Exocet-Polytechnique/exo-template-pcb/template.kicad_pcb

## KiCad design template.kicad_pcb (2026-11-06)

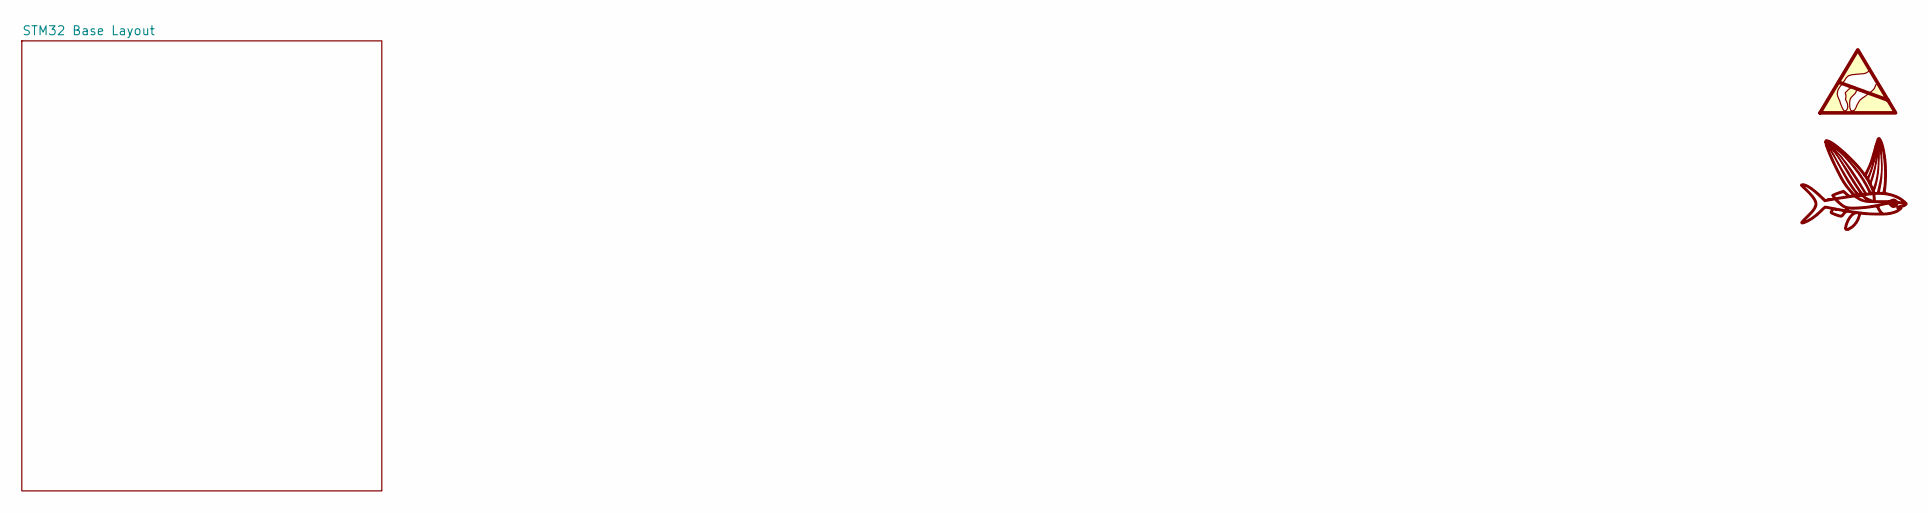
[picture p1: schematic template.kicad_sch, Main page]

Parts:
SYM1: SYM_ESD_Large; ESD-Logo_8.9x8mm_SilkScreen
SYM2: SYM_Logo_Exocet

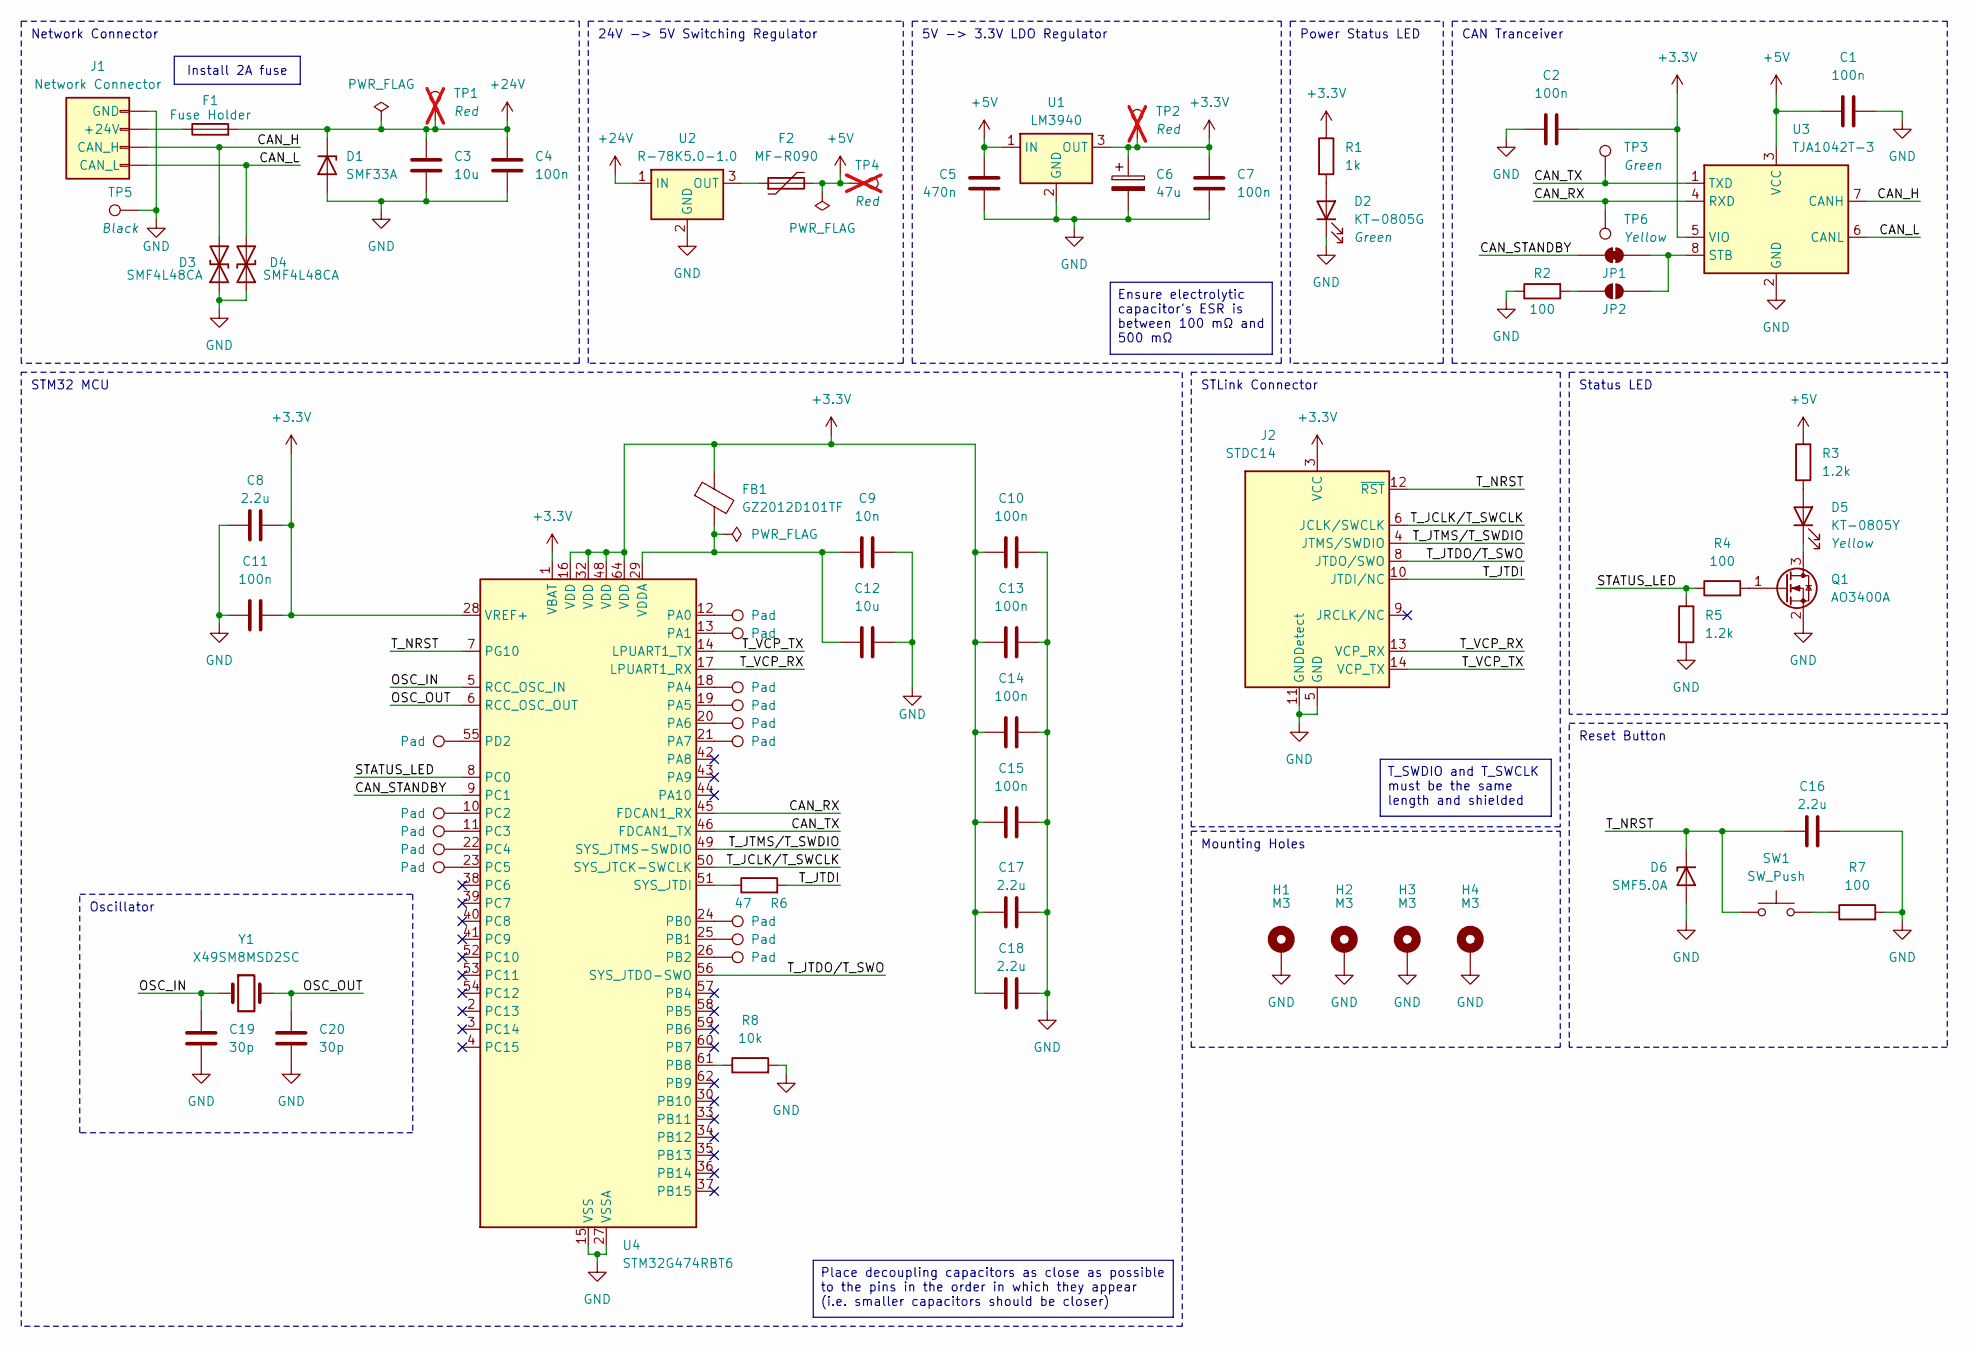
[picture p2: schematic stm32_base.kicad_sch, STM32 Base Layout]

Parts:
C1, C2, C4, C7, C10, C11, C13, C14, C15: 100n; C_0402_1005Metric
C3, C12: 10u; C_1206_3216Metric
C5: 470n; C_0603_1608Metric
C6: 47u; CP_Radial_D5.0mm_P2.00mm
C8, C16, C17, C18: 2.2u; C_0603_1608Metric
C9: 10n; C_0402_1005Metric
C19, C20: 30p; C_0603_1608Metric
D1: SMF33A; D_SOD-123F
D2: KT-0805G; LED_0805_2012Metric_Pad1.15x1.40mm_HandSolder
D3, D4: SMF4L48CA; D_SOD-123F
D5: KT-0805Y; LED_0805_2012Metric
D6: SMF5.0A; D_SOD-123F
F1: Fuse Holder; Fuseholder_Clip-5x20mm_Littelfuse_111_Lateral_P18.80x5.00mm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
F2: MF-R090; PTC_Bourns_MF-R090
FB1: GZ2012D101TF; L_0805_2012Metric
H1, H2, H3, H4: M3; MountingHole_3.2mm_M3_Pad
J1: Network Connector; Connector_Molex_0353180420
J2: STDC14; PinHeader_2x07_P1.27mm_Vertical_SMD
JP1: SolderJumper_2_Bridged; SolderJumper-2_P1.3mm_Bridged_RoundedPad1.0x1.5mm
JP2: SolderJumper_2_Open; SolderJumper-2_P1.3mm_Open_RoundedPad1.0x1.5mm
Q1: AO3400A; SOT-23
R1: 1k; R_0603_1608Metric
R2, R4, R7: 100; R_0603_1608Metric
R3, R5: 1.2k; R_0603_1608Metric
R6: 47; R_0603_1608Metric
R8: 10k; R_0603_1608Metric
SW1: SW_Push; SW_PUSH_6mm
TP1, TP2, TP4: 5005; TestPoint_Keystone_5005-5009_Compact; not fitted
TP3: 5121; TestPoint_Keystone_5005-5009_Compact
TP5: 5006; TestPoint_Keystone_5005-5009_Compact
TP6: 5009; TestPoint_Keystone_5005-5009_Compact
TP7, TP8, TP9, TP10, TP11, TP12, TP13, TP14, TP15, TP16, TP17, TP18, TP19, TP20: Pad; TestPoint_Pad_D1.5mm
U1: LM3940; TO-220-3_Vertical
U2: R-78K5.0-1.0; Converter_DCDC_RECOM_R-78K-1.0_THT
U3: TJA1042T-3; SOIC-8_3.9x4.9mm_P1.27mm
U4: STM32G474RBT6; LQFP-64_10x10mm_P0.5mm
Y1: X49SM8MSD2SC; Crystal_SMD_HC49-SD

Connections:
+3.3V: C2.2, C6.1, C7.1, C8.2, C10.1, C11.2, C13.1, C14.1, C15.1, C17.1, C18.1, FB1.1, J2.3 (VCC), R1.1, TP2.1 (1_1), U1.3 (OUT), U3.5 (VIO), U4.1 (VBAT), U4.16 (VDD), U4.28 (VREF+), U4.32 (VDD), U4.48 (VDD), U4.64 (VDD)
+5V: C1.1, C5.1, F2.2, R3.1, TP4.1 (1_1), U1.1 (IN), U3.3 (VCC)
+24V: C3.1, C4.1, D1.1 (K), F1.2, TP1.1 (1_1), U2.1 (IN)
/STM32 Base Layout/CAN_H: D3.2 (A2), J1.3 (CAN_H), U3.7 (CANH)
/STM32 Base Layout/CAN_L: D4.2 (A2), J1.4 (CAN_L), U3.6 (CANL)
/STM32 Base Layout/CAN_RX: TP6.1 (1_1), U3.4 (RXD), U4.45 (FDCAN1_RX)
/STM32 Base Layout/CAN_STANDBY: JP1.1 (A), U4.9 (PC1)
/STM32 Base Layout/CAN_TX: TP3.1 (1_1), U3.1 (TXD), U4.46 (FDCAN1_TX)
/STM32 Base Layout/OSC_IN: C19.1, U4.5 (RCC_OSC_IN), Y1.1
/STM32 Base Layout/OSC_OUT: C20.1, U4.6 (RCC_OSC_OUT), Y1.2
/STM32 Base Layout/STATUS_LED: R4.1, R5.1, U4.8 (PC0)
/STM32 Base Layout/T_JCLK/T_SWCLK: J2.6 (JCLK/SWCLK), U4.50 (SYS_JTCK-SWCLK)
/STM32 Base Layout/T_JTDI: J2.10 (JTDI/NC), R6.2
/STM32 Base Layout/T_JTDO/T_SWO: J2.8 (JTDO/SWO), U4.56 (SYS_JTDO-SWO)
/STM32 Base Layout/T_JTMS/T_SWDIO: J2.4 (JTMS/SWDIO), U4.49 (SYS_JTMS-SWDIO)
/STM32 Base Layout/T_NRST: C16.1, D6.1 (K), J2.12 (~RST), SW1.1, U4.7 (PG10)
/STM32 Base Layout/T_VCP_RX: J2.13 (VCP_RX), U4.17 (LPUART1_RX)
/STM32 Base Layout/T_VCP_TX: J2.14 (VCP_TX), U4.14 (LPUART1_TX)
GND: C1.2, C2.1, C3.2, C4.2, C5.2, C6.2, C7.2, C8.1, C9.2, C10.2, C11.1, C12.2, C13.2, C14.2, C15.2, C16.2, C17.2, C18.2, C19.2, C20.2, D1.2 (A), D2.1 (K), D3.1 (A1), D4.1 (A1), D6.2 (A), H1.1 (1_1), H2.1 (1_1), H3.1 (1_1), H4.1 (1_1), J1.1 (GND), J2.5 (GND), J2.7 (GND), J2.11 (GNDDetect), Q1.2 (S), R2.1, R5.2, R7.2, R8.2, TP5.1 (1_1), U1.2 (GND), U2.2 (GND), U3.2 (GND), U4.15 (VSS), U4.27 (VSSA), U4.31 (VSS), U4.47 (VSS), U4.63 (VSS)
unnamed: D2.2 (A), R1.2
unnamed: D5.2 (A), R3.2
unnamed: D5.1 (K), Q1.3 (D)
unnamed: F1.1, J1.2 (+24V)
unnamed: JP1.2 (B), JP2.1 (A), U3.8 (STB)
unnamed: JP2.2 (B), R2.2
unnamed: Q1.1 (G), R4.2
unnamed: R7.1, SW1.2
unnamed: F2.1, U2.3 (OUT)
unnamed: TP7.1 (1_1), U4.12 (PA0)
unnamed: TP8.1 (1_1), U4.13 (PA1)
unnamed: TP9.1 (1_1), U4.18 (PA4)
unnamed: TP10.1 (1_1), U4.19 (PA5)
unnamed: TP11.1 (1_1), U4.20 (PA6)
unnamed: TP13.1 (1_1), U4.21 (PA7)
unnamed: R6.1, U4.51 (SYS_JTDI)
unnamed: TP18.1 (1_1), U4.24 (PB0)
unnamed: TP19.1 (1_1), U4.25 (PB1)
unnamed: TP20.1 (1_1), U4.26 (PB2)
unnamed: R8.1, U4.61 (PB8)
unnamed: TP14.1 (1_1), U4.10 (PC2)
unnamed: TP15.1 (1_1), U4.11 (PC3)
unnamed: TP16.1 (1_1), U4.22 (PC4)
unnamed: TP17.1 (1_1), U4.23 (PC5)
unnamed: TP12.1 (1_1), U4.55 (PD2)
unnamed: C9.1, C12.1, FB1.2, U4.29 (VDDA)

Notes on the sheet:
Oscillator
Reset Button
Mounting Holes
5V -> 3.3V LDO Regulator
CAN Tranceiver
24V -> 5V Switching Regulator
Status LED
STLink Connector
Power Status LED
Network Connector
STM32 MCU
T_SWDIO and T_SWCLK must be the same length and shielded
Ensure electrolytic capacitor's ESR is between 100 mΩ and 500 mΩ
Install 2A fuse
Place decoupling capacitors as close as possible to the pins in the order in which they appear (i.e. smaller capacitors should be closer)

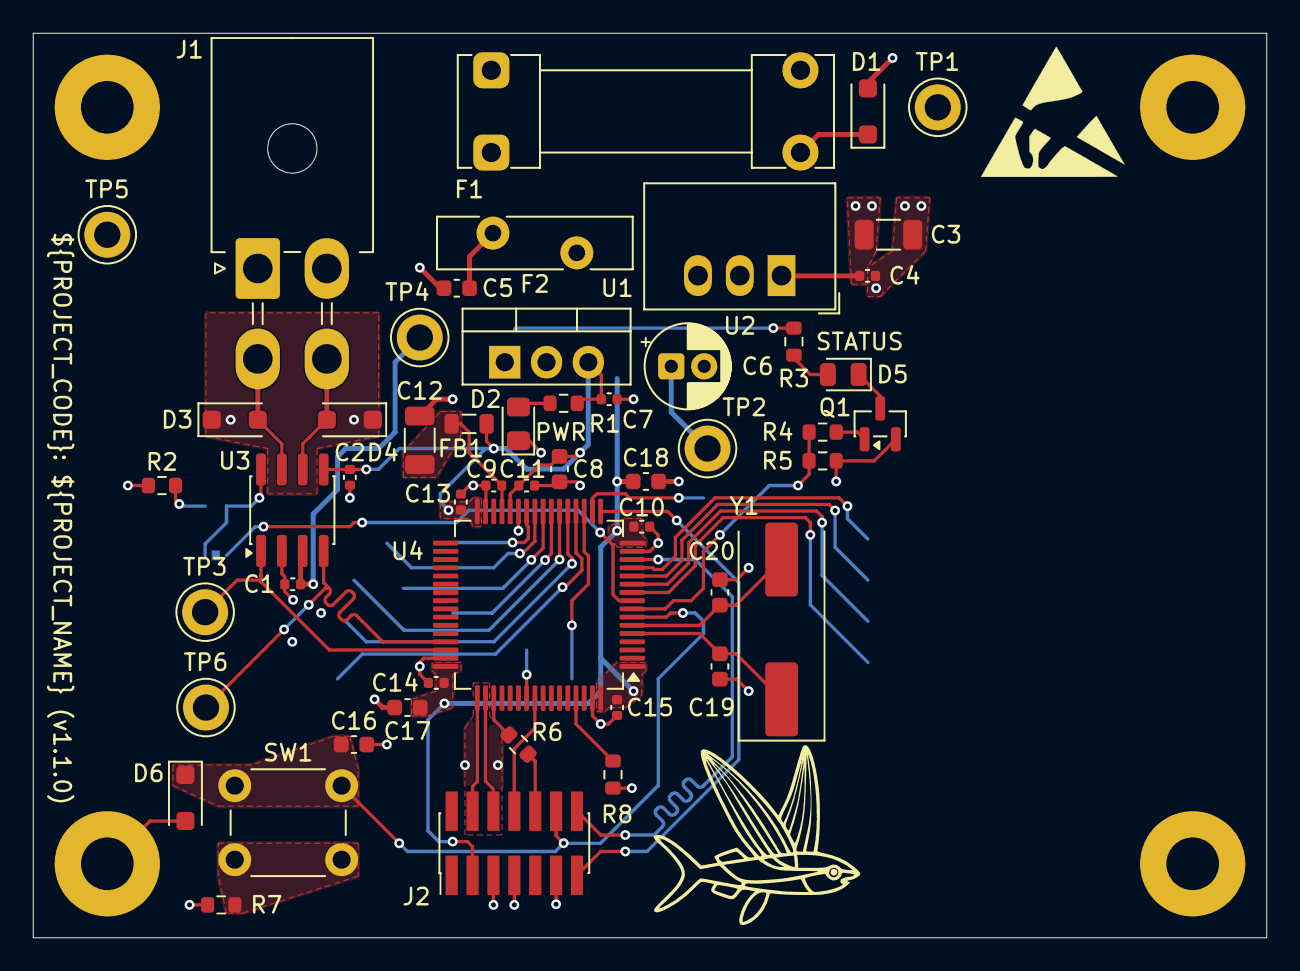
[picture p3: board template.kicad_pcb from above]

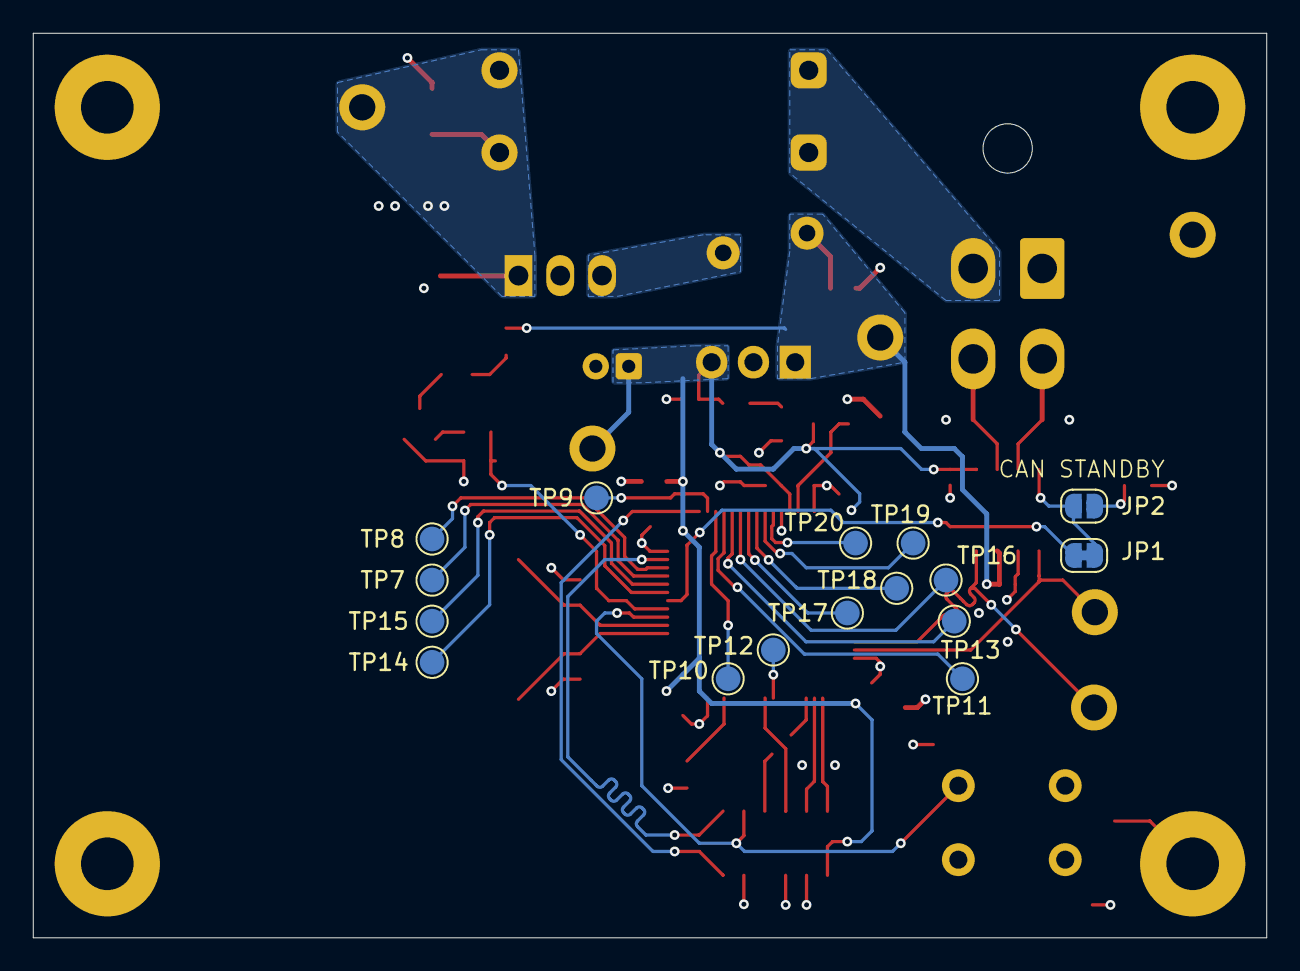
[picture p4: board template.kicad_pcb from below]

Board: 4 copper layers, 75.0 x 55.0 mm, 74 parts (16 on the bottom side), 45 nets.
