Exocet-Polytechnique/exo-template-pcb/(commit log)

2026-10-11 template-pcb: Add existing template
    [stm32_base.kicad_sch, template.kicad_pcb]
2026-10-12 Exo-template-pcb : add older version changes
    [stm32_base.kicad_sch, template.kicad_pcb, template.kicad_sch]
2026-10-12 Exo-template-pcb : Add new protective diodes/
    [stm32_base.kicad_sch]
2026-10-13 Exo-template-pcb : Add ferrite bead and footprints
    [stm32_base.kicad_sch]
2026-10-14 Add transceiver CAN for 24V network
    [stm32_base.kicad_sch]
2026-10-15 Add 24 V to 5 V Voltage Regulator
    [stm32_base.kicad_sch]
2026-10-15 Exo-template-pcb : Add regulator 3.3V
    [stm32_base.kicad_sch]
2026-10-15 Exo-template-pcb : footprints library resolve
    [stm32_base.kicad_sch]
2026-10-15 Exo-template-pcb : Resolve all issues - add 3.3V regulator - add jlcpcb numbers
    [stm32_base.kicad_sch]
2026-10-16 Removed copy folder, add schematic page with hierarchical reference
    [stm32_base.kicad_sch, template.kicad_pcb, template.kicad_sch]
2026-10-22 Implement review comments
    [stm32_base.kicad_sch]
2026-10-23 schem: move a few passives and change some fields
    [stm32_base.kicad_sch]
2026-10-31 project: move files to root and update metadata
    Also deleted the '_library' directory since it is now a separate
    repository.
    [stm32_base.kicad_sch, template.kicad_pcb, template.kicad_sch]
2026-11-02 schematic: clean and reorganise schem.; add IPNs
    [stm32_base.kicad_sch, template.kicad_pcb, template.kicad_sch]
2026-11-02 schematic: add jlcpcb part numbers and DNP
    [stm32_base.kicad_sch, template.kicad_pcb, template.kicad_sch]
2026-11-03 board: place and route all components
    [stm32_base.kicad_sch, template.kicad_pcb, template.kicad_sch]
2026-11-06 board: cleanup F.Fab and few traces
    Cleanup F.Fab text, adjusted CAN_RX trace size, aligned SWCLK/SWDIO
    traces
    [template.kicad_pcb]
2026-11-06 board: fix CAN_RX/CAN_TX length
    Also moved a B.Silkscreen label away from a via.
    [template.kicad_pcb]
